fatihcesur/bmw-f30-cluster-simhub/docs/cc_atlas/sheets/sheet_0000_0049.jpg

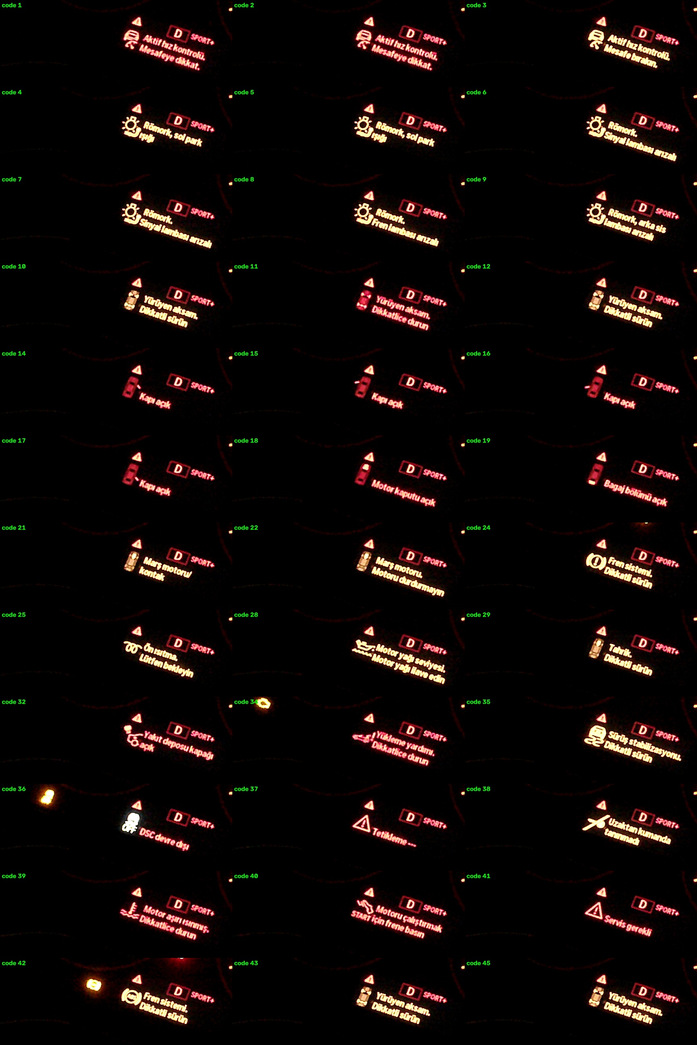
docs/cc_atlas/sheets/sheet_0000_0049.jpg
