fatihcesur/bmw-f30-cluster-simhub/docs/cc_atlas/sheets/sheet_0020_0049.jpg

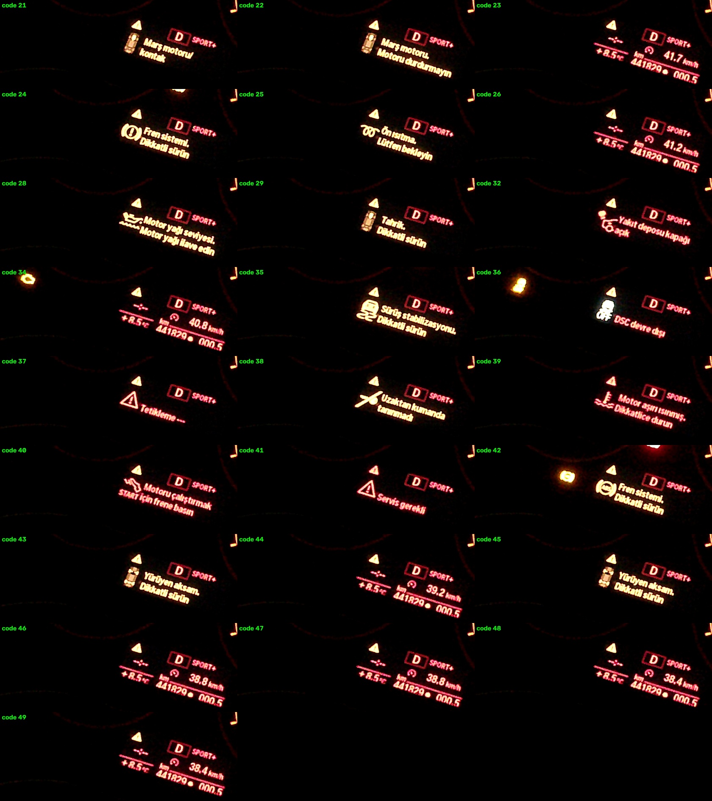
docs/cc_atlas/sheets/sheet_0020_0049.jpg
