fatihcesur/bmw-f30-cluster-simhub/docs/cc_atlas/sheets/sheet_0050_0099.jpg

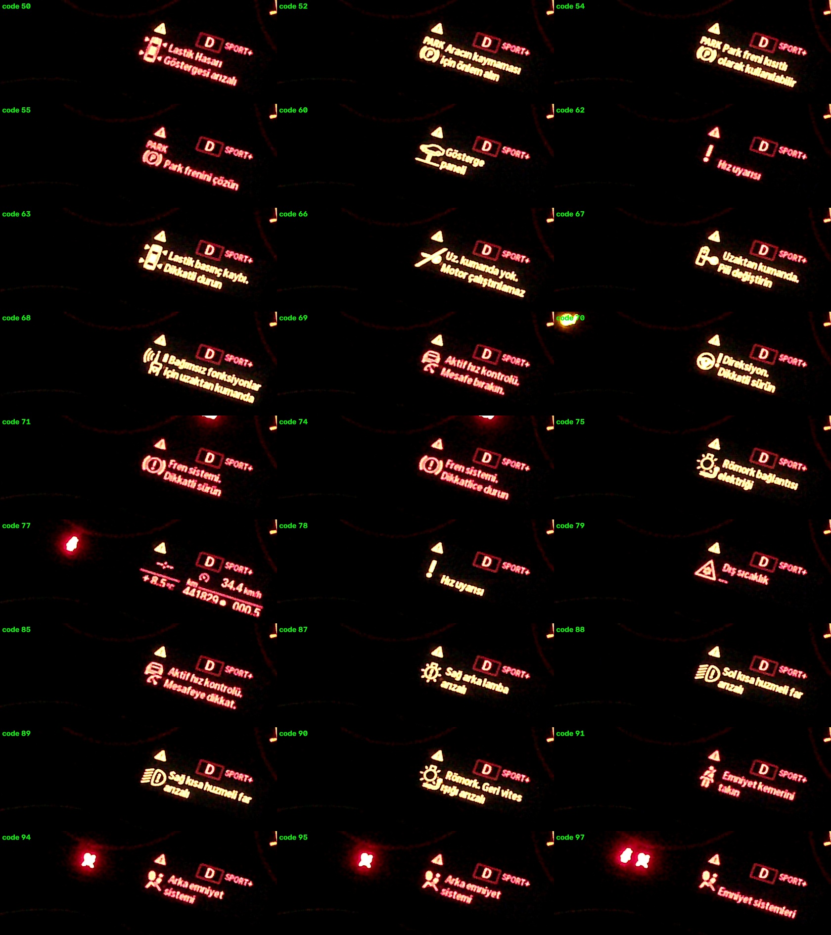
docs/cc_atlas/sheets/sheet_0050_0099.jpg
