fatihcesur/bmw-f30-cluster-simhub/docs/cc_atlas/sheets/sheet_0100_0149.jpg

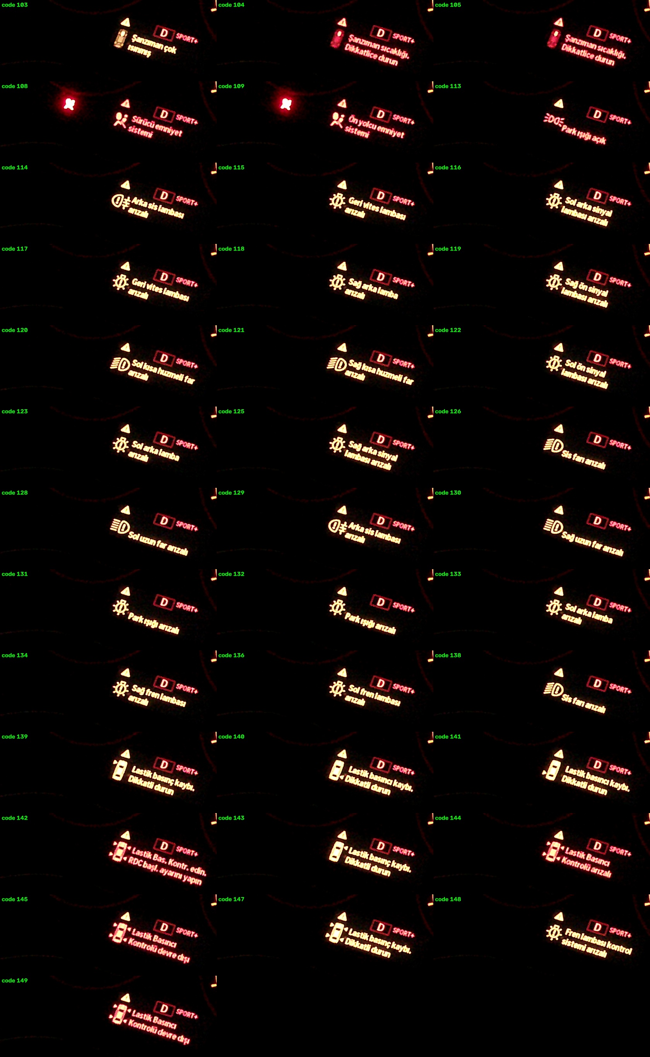
docs/cc_atlas/sheets/sheet_0100_0149.jpg
