fatihcesur/bmw-f30-cluster-simhub/docs/cc_atlas/sheets/sheet_0225_0299.jpg

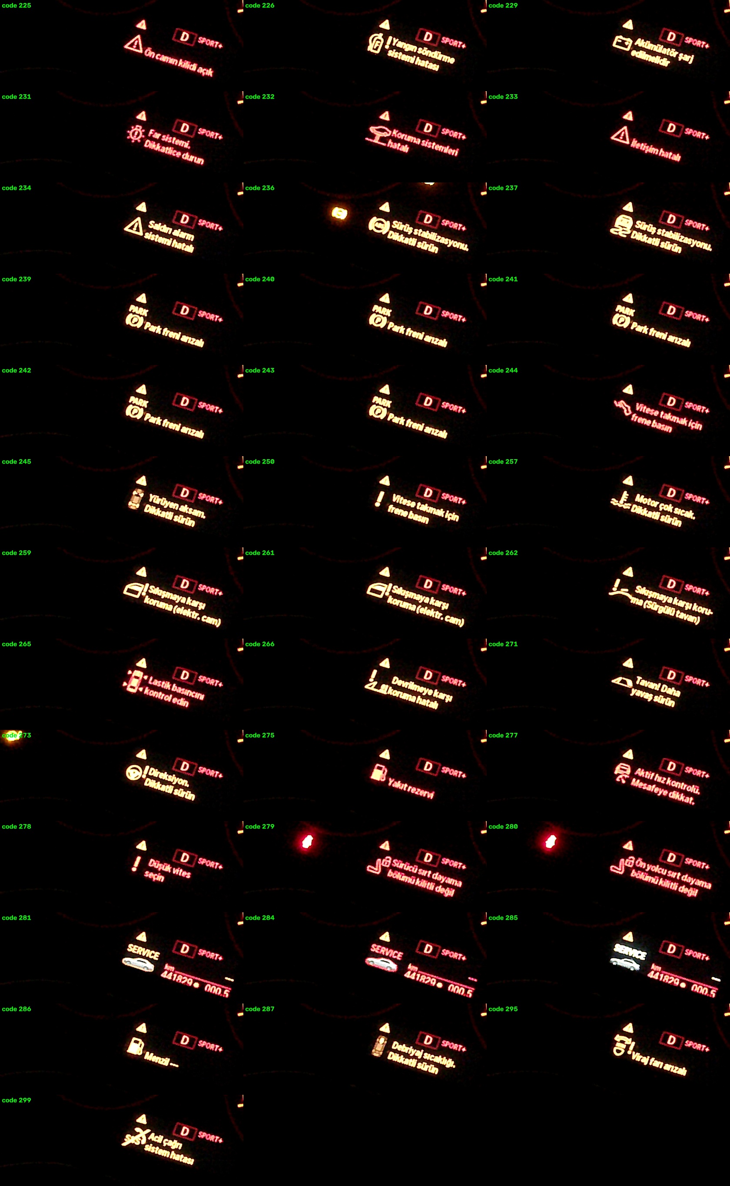
docs/cc_atlas/sheets/sheet_0225_0299.jpg
