fatihcesur/bmw-f30-cluster-simhub/docs/cc_atlas/sheets/sheet_0450_0499.jpg

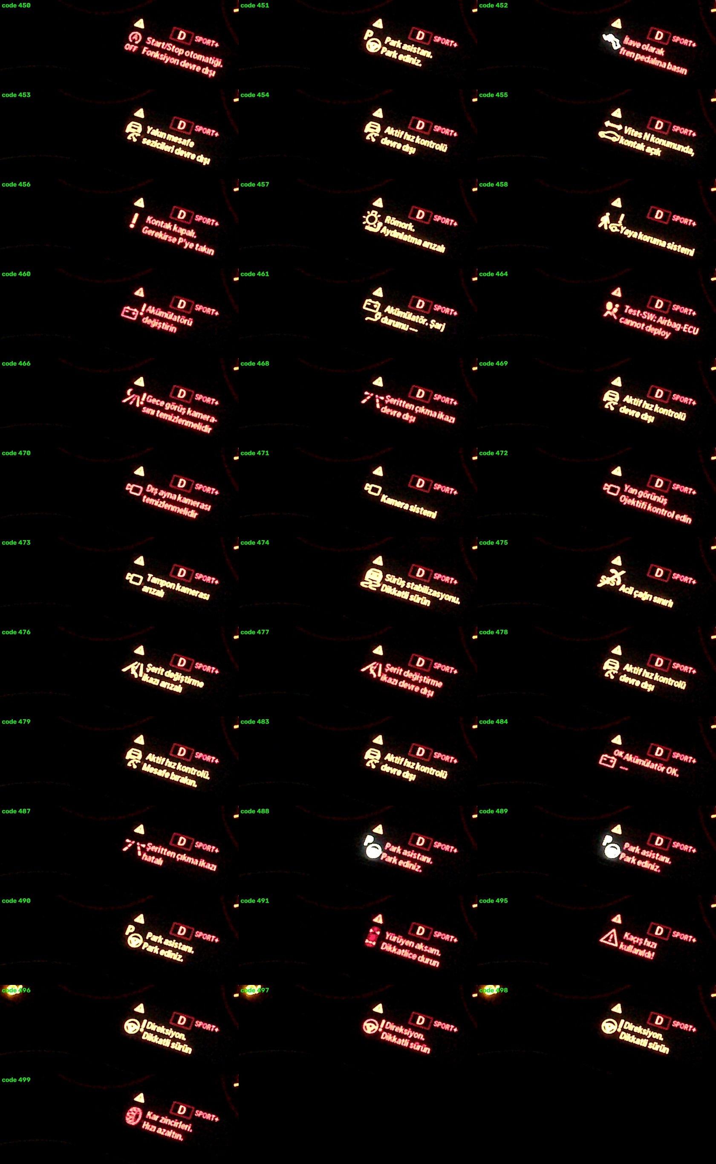
docs/cc_atlas/sheets/sheet_0450_0499.jpg
