fatihcesur/bmw-f30-cluster-simhub/docs/cc_atlas/sheets/sheet_0650_0699.jpg

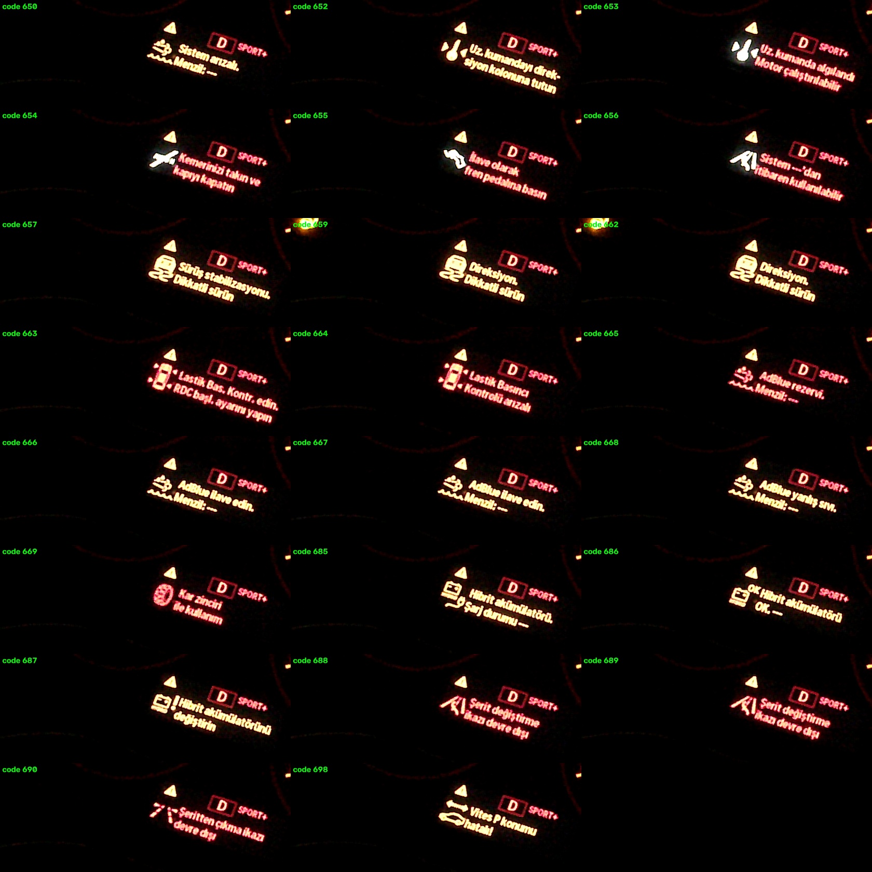
docs/cc_atlas/sheets/sheet_0650_0699.jpg
