fatihcesur/bmw-f30-cluster-simhub/docs/cc_atlas/sheets/sheet_0700_0749.jpg

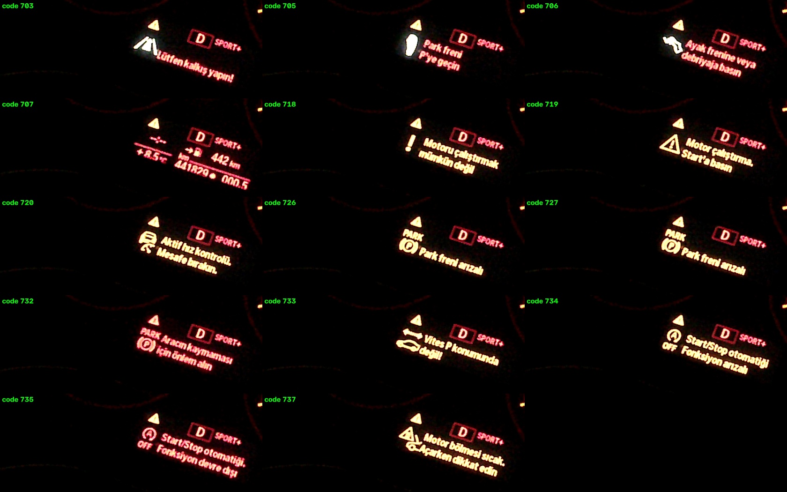
docs/cc_atlas/sheets/sheet_0700_0749.jpg
