fatihcesur/bmw-f30-cluster-simhub/docs/cc_atlas/sheets/sheet_0750_0799.jpg

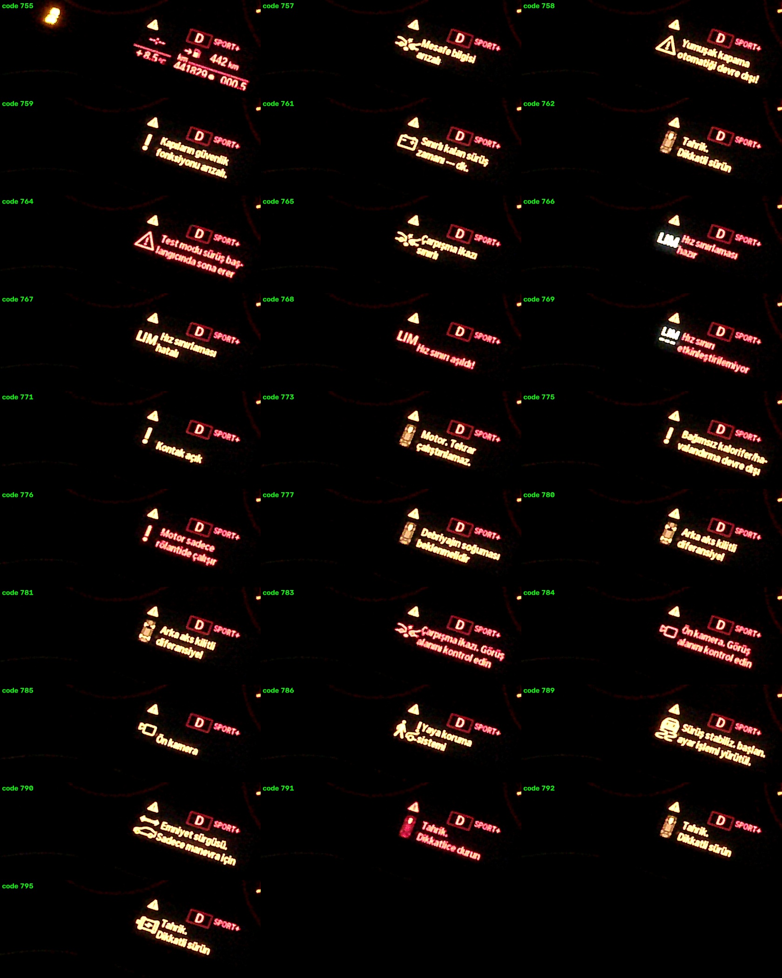
docs/cc_atlas/sheets/sheet_0750_0799.jpg
