fatihcesur/bmw-f30-cluster-simhub/docs/cc_atlas/sheets/sheet_0900_0949.jpg

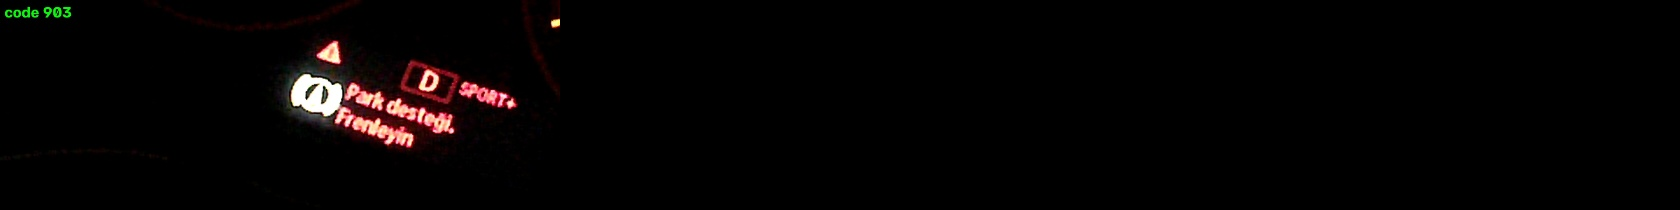
docs/cc_atlas/sheets/sheet_0900_0949.jpg
