fatihcesur/bmw-f30-cluster-simhub/docs/images/2026-10-08/amber_leds_before.jpg

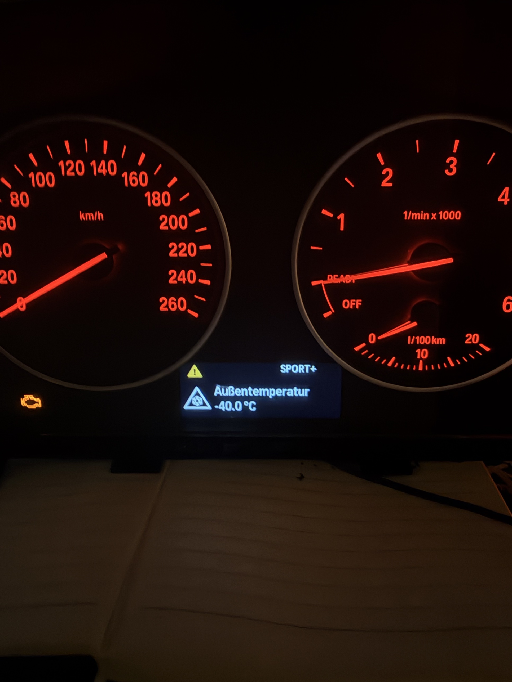
docs/images/2026-10-08/amber_leds_before.jpg
