fatihcesur/bmw-f30-cluster-simhub/docs/images/2026-10-08/white_leds_after.jpg

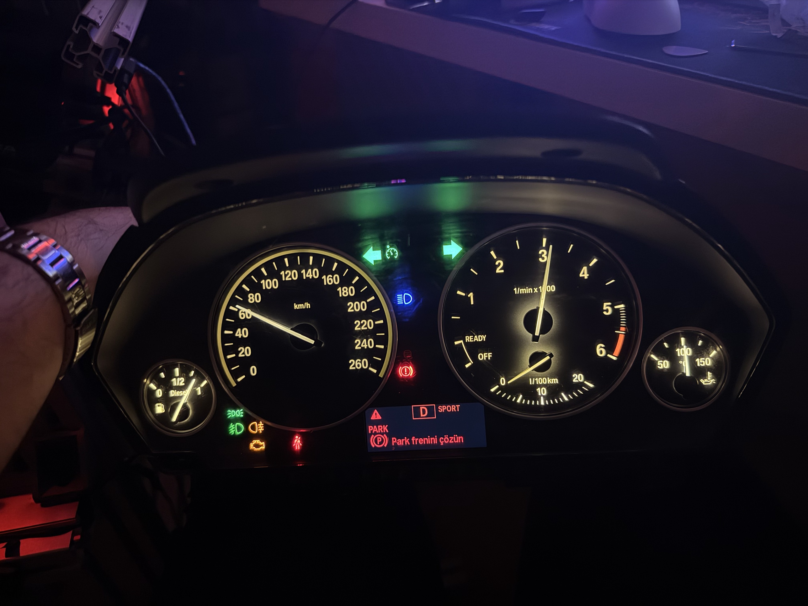
docs/images/2026-10-08/white_leds_after.jpg
