fatihcesur/bmw-f30-cluster-simhub/docs/images/highlights/eco_pro_mode.jpg

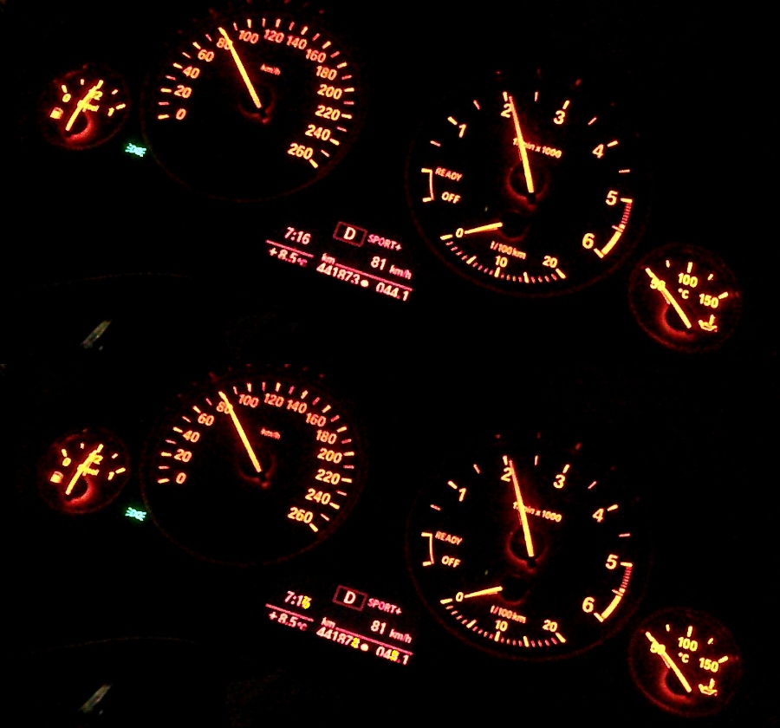
docs/images/highlights/eco_pro_mode.jpg
