fatihcesur/bmw-f30-cluster-simhub/docs/images/highlights/loading_assist_popup_0x289_sweep.jpg

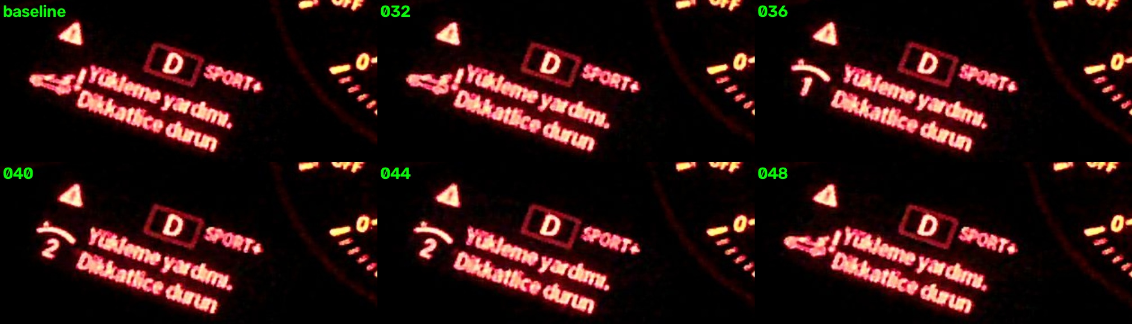
docs/images/highlights/loading_assist_popup_0x289_sweep.jpg
