fatihcesur/bmw-f30-cluster-simhub/docs/images/lamps/centre_column_dsc_brake.jpg

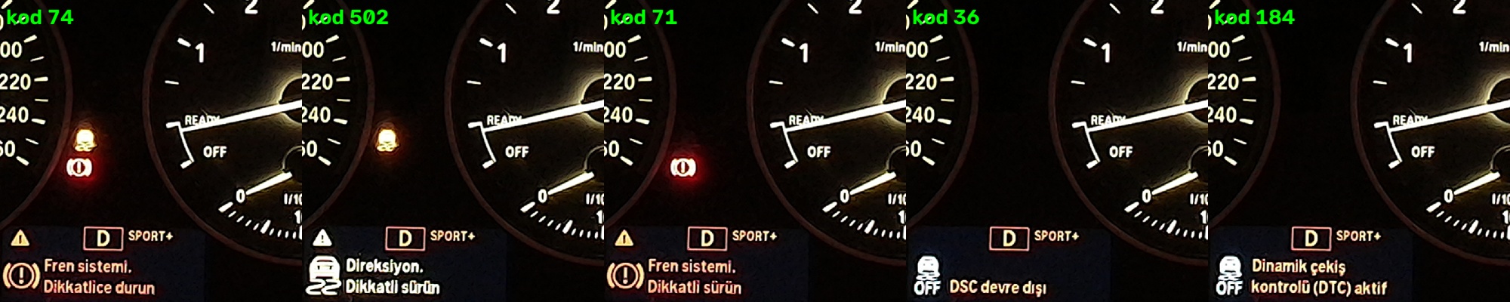
docs/images/lamps/centre_column_dsc_brake.jpg
