fatihcesur/bmw-f30-cluster-simhub/docs/images/lamps/lamp_codes_sheet_0.jpg

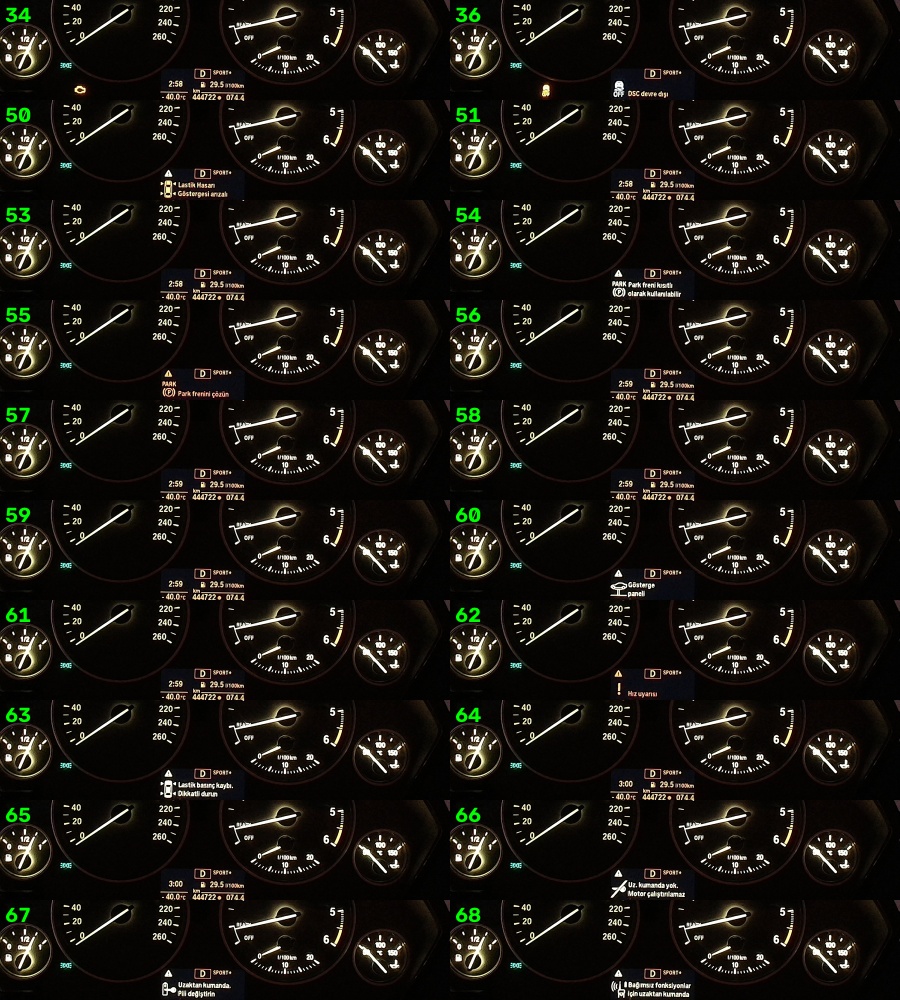
docs/images/lamps/lamp_codes_sheet_0.jpg
