fatihcesur/bmw-f30-cluster-simhub/tools/cc_scanner/frames/fake_20.jpg

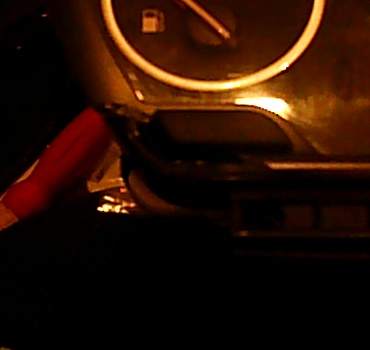
tools/cc_scanner/frames/fake_20.jpg
