fatihcesur/bmw-f30-cluster-simhub/tools/cc_scanner/frames/fake_30.jpg

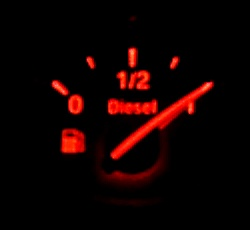
tools/cc_scanner/frames/fake_30.jpg
