fatihcesur/bmw-f30-cluster-simhub/tools/cc_scanner/frames/fake_full.jpg

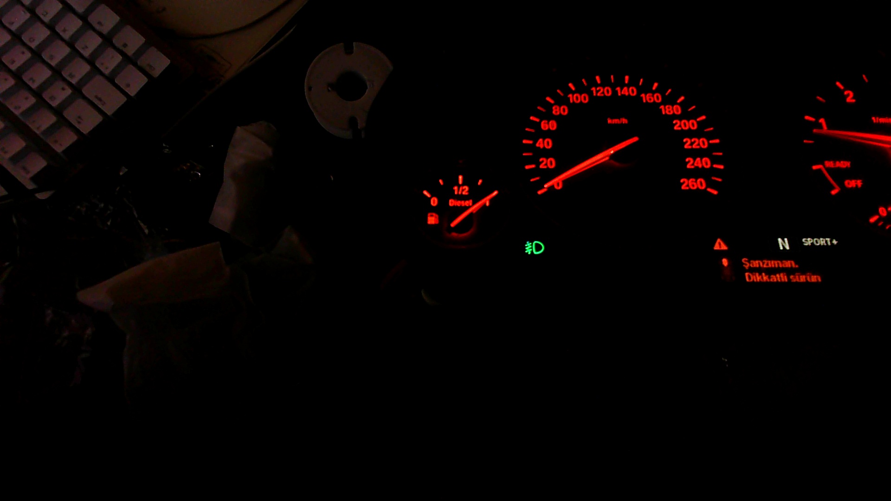
tools/cc_scanner/frames/fake_full.jpg
