fatihcesur/bmw-f30-cluster-simhub/tools/cc_scanner/frames/now_full.jpg

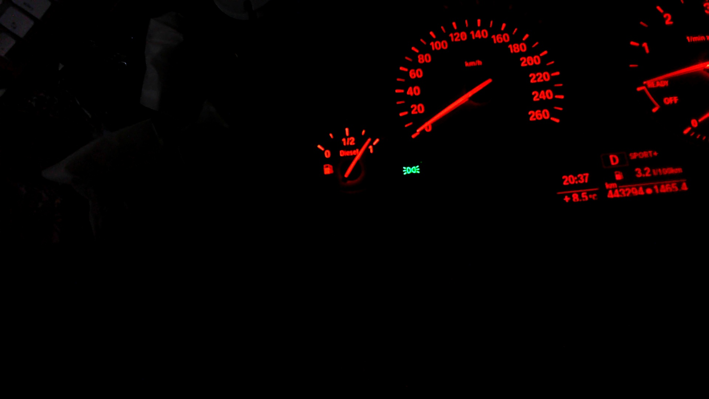
tools/cc_scanner/frames/now_full.jpg
