fatihcesur/bmw-f30-cluster-simhub/tools/cc_scanner/frames/rawcheck2.jpg

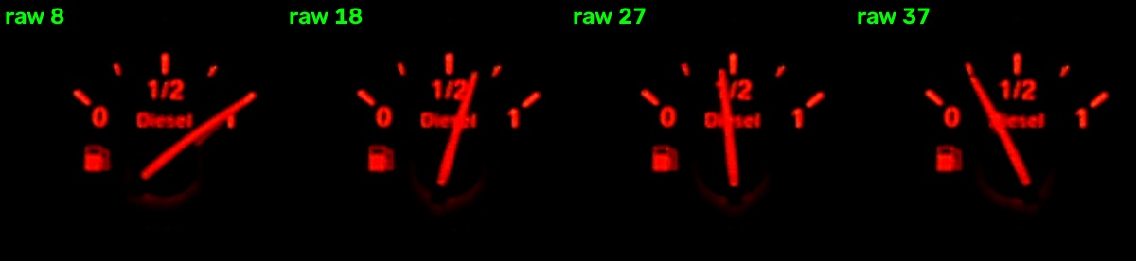
tools/cc_scanner/frames/rawcheck2.jpg
