fatihcesur/bmw-f30-cluster-simhub/tools/cc_scanner/frames/reframe.jpg

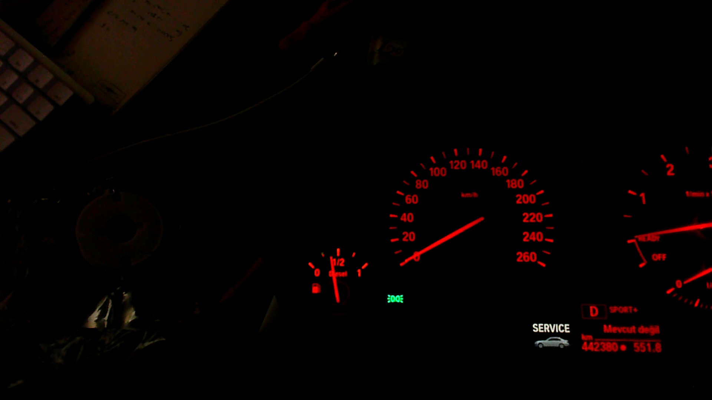
tools/cc_scanner/frames/reframe.jpg
