fatihcesur/bmw-f30-cluster-simhub/tools/cc_scanner/frames/t_after.jpg

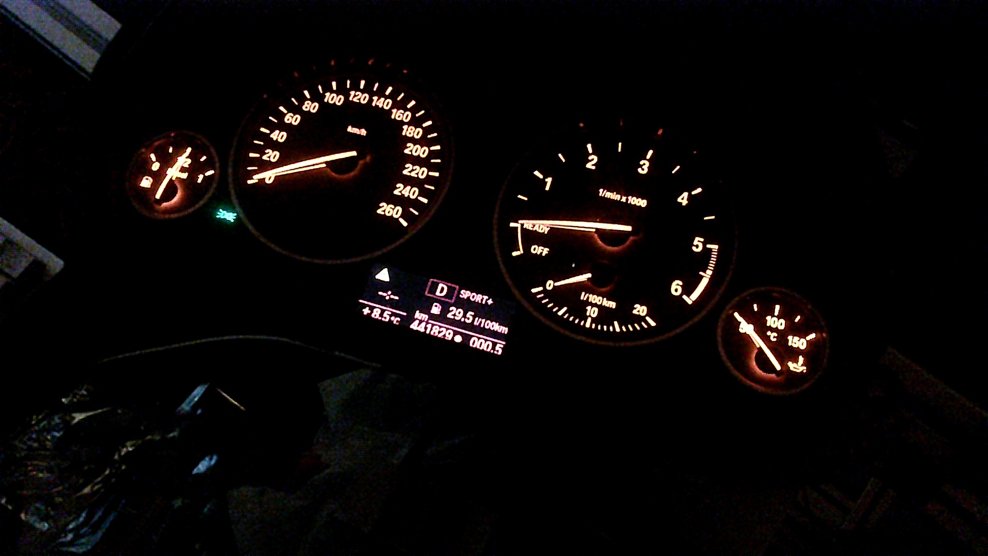
tools/cc_scanner/frames/t_after.jpg
