fatihcesur/bmw-f30-cluster-simhub/docs/archive/2026-10-04/fuel_test/refuel1_phases.csv

0.0 | settle
60.3 | drive
70.5 | stop
76.1 | ignoff
81.1 | refuel
96.2 | full
101.2 | ignon
104.9 | driveoff
165.3 | park
