fatihcesur/bmw-f30-cluster-simhub/docs/archive/2026-10-04/fuel_test/refuel2_phases.csv

0.0 | settle
60.3 | drive
70.5 | stop
75.7 | ignoff
80.7 | refuel
110.9 | full
115.9 | ignon
119.6 | driveoff
180.0 | park
