fatihcesur/bmw-f30-cluster-simhub/docs/archive/2026-10-04/fuel_test/refuel3_phases.csv

0.0 | settle
60.3 | drive
70.6 | stop
75.6 | ignoff
80.6 | refuel
110.8 | full
123.3 | ignon
128.9 | driveoff
189.5 | park
