fatihcesur/bmw-f30-cluster-simhub/docs/images/highlights/cruise_set_speed_marker_firmware_test.jpg

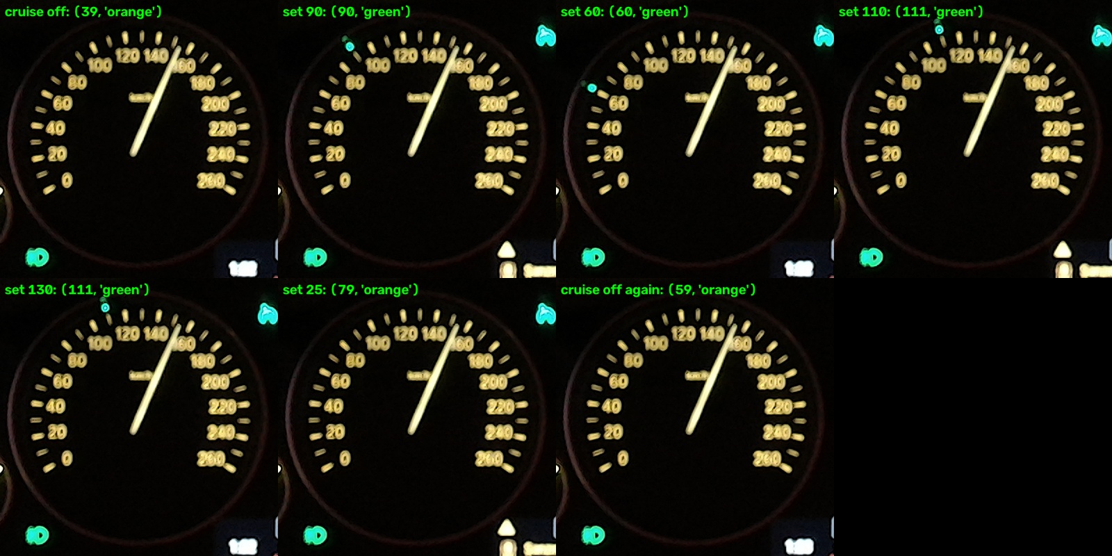
docs/images/highlights/cruise_set_speed_marker_firmware_test.jpg
