fatihcesur/bmw-f30-cluster-simhub/firmware/bmw_f30_cluster/local_config.example.h

// Copy to local_config.h (git-ignored) and adjust for your cluster.
#define SPEED_NEEDLE_GAIN 1.0         // e.g. 1.03 if 100 km/h reads 97 when you look head-on
#define SPEED_NEEDLE_OFFSET_KMH 0.0   // e.g. 4.5 if the speed needle rests below the 0 mark
#define CRUISE_MARKER_OFFSET_KMH 0    // km/h the cruise set-speed marker sits too high
