fatihcesur/bmw-f30-cluster-simhub/(commit log)

2026-10-08 BMW F30 instrument cluster for SimHub
    Real BMW F30 instrument cluster driven by an Arduino Nano + MCP2515 over CAN, live
    from any SimHub game (ETS2/ATS, Assetto Corsa/ACC, BeamNG and others).
    Firmware, game-aware SimHub formula, development log, CAN research, check-control
    code photo atlas, bench diagnostics and webcam scanner tools.
2026-10-08 Remove dark, mis-aimed and duplicate images
    Drops near-black and mis-aimed webcam frames, a camera-probe frame, identical gauge crops,
    and downscaled copies of SLI scan images whose full-size versions are kept.
2026-10-08 Notes: CAN-L leak traced to the module-side USB-C breakout board
2026-10-08 Cruise set-speed marker on the speedometer (0x289), found with a webcam hunt
    byte1 0x22 lights the green marker, byte5/6 carry the set speed x16. The firmware shows
    the game's cruise speed between 30 and 110 km/h, compensating the arm's 28 km/h offset.
    Adds the hunt/tracking scripts and the welcome-sweep note.
2026-10-08 Speed needle +3 % trim after re-seating; needle calibration script
    Head-on reading: 100 km/h sent showed 97.
2026-10-29 Cruise marker: orange while cruise is suspended, cleared at ignition off
    Last set speed is remembered when the game drops cruise (brake). Marker and cruise icon
    share 0x289 byte4 bit7, so the icon stays on while orange. Verified on camera.
2026-10-29 Lights: real green parking-light icon with headlights, fog icons only for fog
    0x21A bit 0x04 (lights icon) plus 0x2A5 ambient = day keeps the MID text white. Verified on
    camera: lights -> park icon, fog -> front (green) + rear (amber) fog, text stays white.
2026-10-29 Speed needle: constant +4.5 km/h trim (local_config) instead of 3 % gain
    Brio head-on: tach exact 500-6000; speed needle read ~4.5 km/h low everywhere. With the
    offset 20/60/100/140 sit on the marks. The 0 position can't be lifted in software (the
    moving flag at standstill pops the parking-brake warning).
2026-10-29 fake SimHub: accept gear letters on the command line
2026-11-05 Firmware builds for STM32F103 Blue Pill (MCP2515 on SPI2) as well as the Nano
    Not yet tested on hardware. Blue Pill pins: MCP2515 CS PB12, INT PA8, SCK PB13, SO PB14, SI PB15 (all 5 V tolerant); buttons PB5-PB9. SimHub talks over the Blue Pill's own USB (CDC).
2026-11-05 README: STM32 Blue Pill wiring and board settings (tested on the bench)
2026-11-05 STM32 Blue Pill only: drop the Nano build, bench tools on Blue Pill pins
    The Blue Pill runs more smoothly than the Nano, so the firmware now targets it alone (compiling for another board stops with #error). alltest, candiag and loopdiag use the same MCP2515 pins (CS PB12, SPI2 PB13-PB15). README, LIBRARIES and NOTES describe the Blue Pill wiring and board settings.
